ManuZ96/T3200_Manuel_Zieker/inhalt/strukturierung/eigenstaendigkeit.tex

% !TeX root = ../main.tex
% Zeile 1 legt fest das immer die main.tex kompiliert wird

\chapter*{Eigenständigkeitserklärung}

Hiermit erkläre ich, dass ich die vorliegende
Studienarbeit T3200 mit dem Titel „Entwicklung einer WordClock mit funktionalen Zusatzinformationen und Smart-Home-Integration“ selbstständig verfasst habe und keine anderen als die angegebenen Quellen und Hilfsmittel benutzt wurden.
Alle sinngemäß und wörtlich übernommenen Textstellen aus fremden Quellen wurden kenntlich gemacht.

\releaseLocation, \releaseDate
\vspace{2em}

\rule{6cm}{0.4pt}\\
Manuel Zieker
%Einkommentieren für 2. Author
% \rule{6cm}{0.4pt}\\
% <Authorname hier>\\
% \vspace{2em}
