ManuZ96/T3200_Manuel_Zieker/inhalt/abkürzungsverzeichnis/abkuerzungsverzeichniss.tex

% ========================
% VERWENDETE ABKÜRZUNGEN
% ========================
% (Erstes auftauchen)

%200
\newacronym{diy}{DIY}{Do-It-Yourself}
\newacronym{esp32}{ESP32}{Espressif 32 Mikrocontroller}
\newacronym{led}{LED}{Light Emitting Diode}
\newacronym{api}{API}{Application Programming Interface}
\newacronym{wlan}{WLAN}{Wireless Local Area Network}
%320
\newacronym{it}{IT}{Informationstechnik}
%330
\newacronym{ws2812b}{WS2812B}{Adressierbare RGB-LED mit integrierter Steuerelektronik}
\newacronym{rgb}{RGB}{Rot Grün Blau}
%340
\newacronym{iot}{IoT}{Internet of Things}
%351
\newacronym{esp32c6}{ESP32-C6}{Mikrocontroller von Espressif}
\newacronym{ble}{BLE}{Bluetooth Low Energy}
\newacronym{ieee802154}{IEEE 802.15.4}{Standard für drahtlose Netzwerke mit geringem Energieverbrauch}
\newacronym{usb}{USB}{Universal Serial Bus}
%352
\newacronym{ntp}{NTP}{Network Time Protocol}
%361
\newacronym{ip}{IP}{Internet Protocol}
\newacronym{dhcp}{DHCP}{Dynamic Host Configuration Protocol}
%362
\newacronym{http}{HTTP}{Hypertext Transfer Protocol}
\newacronym{tcp}{TCP}{Transmission Control Protocol}
\newacronym{html}{HTML}{Hypertext Markup Language}
\newacronym{css}{CSS}{Cascading Style Sheets}
\newacronym{url}{URL}{Uniform Resource Locator}
%372
\newacronym{https}{HTTPS}{Hypertext Transfer Protocol Secure}
\newacronym{ssl}{SSL}{Secure Sockets Layer}
\newacronym{tls}{TLS}{Transport Layer Security}
\newacronym{rest}{REST}{Representational State Transfer}
%510
\newacronym{dht22}{DHT22}{Digitaler Temperatur- und Feuchtigkeitssensor}
%520
\newacronym{json}{JSON}{JavaScript Object Notation}
%526
\newacronym{ui}{UI}{User Interface}
%600
\newacronym{3ddrucker}{3D-Drucker}{Gerät zur additiven Fertigung dreidimensionaler Objekte durch schichtweisen Materialauftrag}
%610
\newacronym{pla}{PLA}{Polylactid, ein biologisch abbaubarer thermoplastischer Kunststoff auf Basis nachwachsender Rohstoffe wie Maisstärke oder Zuckerrohr, der häufig im 3D-Druck eingesetzt wird}
\newacronym{3ddruck}{3D-Druck}{Fertigungsverfahren zur Herstellung dreidimensionaler Objekte}
\newacronym{cad}{CAD}{Computer-Aided Design}
\newacronym{usb-c}{USB-C}{Universal Serial Bus Typ C}
%620
\newacronym{gpio}{GPIO}{General Purpose Input/Output}
%620
\newacronym{wifi}{Wi-Fi}{Wireless Fidelity}

% ========================
% BEISPIELE LÖSCHEN!
% ========================
%\newacronym{DHBW}{DHBW}{Duale Hochschule Baden-Württemberg}

% ========================
% ANWENDUNG
% ========================
% Im Text abkürzung verwenden mit: \gls{<hier die abkürzung>}
% Bsp.: \gls{emf} --> erstes mal im Text kommt „elektromotorische Kraft (EMF)“
%                 --> beim 2. Mal und danach: "EMF"
