ManuZ96/T3200_Manuel_Zieker/inhalt/strukturierung/KI-Tools.tex

% !TeX root = ../main.tex
% Zeile 1 legt fest das immer die main.tex kompiliert wird

\chapter*{Anmerkung zum Einsatz von KI-Werkzeugen}

Künstliche Intelligenz entwickelt sich rasant weiter und wird in immer mehr Unternehmen produktiv genutzt, um Arbeitsabläufe zu beschleunigen und Ergebnisse effizienter zu erzielen. 
In dieser Arbeit wurde das Werkzeuge ChatGPT als Programmierhilfe und zur Überarbeitung der Grammatik verwendet. 
Die Verantwortung für Auswahl, Interpretation und Korrektheit der dargestellten Ergebnisse liegt bei mir.
