ManuZ96/T3200_Manuel_Zieker/inhalt/strukturierung/genus.tex

% !TeX root = ../main.tex
% Zeile 1 legt fest das immer die main.tex kompiliert wird

\chapter*{Anmerkung zum Genus des Substantivs}

Auf geschlechtsspezifische Umschreibung ist hier verzichtet worden. Ein Maskulinum - wie zum Beispiel der Student - meint (selbstredend) auch weibliche und diverse Personen.
