ManuZ96/T3200_Manuel_Zieker/inhalt/textkapitel/Kapitel 6/660_Integration der UI Steuerung.tex

\section{Integration der UI-Steuerung}
Zur Steuerung des Systems wird ein integrierter Webserver implementiert, welcher direkt auf dem Mikrocontroller ausgeführt wird.  
Die Kommunikation erfolgt über \gls{http}, sodass der Zugriff über einen Webbrowser möglich ist.
Die \gls{ui} ermöglicht das Ein- und Ausschalten der WordClock sowie die Anpassung von Helligkeit und Farbwerten.  
Die Verarbeitung der Nutzereingaben erfolgt über URL-Parameter.

\begin{lstlisting}[style=arduino,caption={Verarbeitung der Nutzereingaben über URL-Parameter.}]
void handleSet() {
  bool changed = false;

  if (server.hasArg("power")) {
    int p = server.arg("power").toInt();
    lampPower = (p != 0);
    changed = true;
  }

  if (server.hasArg("brightness")) {
    int b = server.arg("brightness").toInt();
    if (b < 0) b = 0;
    if (b > 100) b = 100;
    webBrightness = b;
    changed = true;
  }

  if (changed) {
    showHourWord(currentHour);
  }
  server.sendHeader("Location", "/", true);
  server.send(302, "text/plain", "OK");
}
\end{lstlisting}

Zusätzlich wird eine \gls{json}-Schnittstelle bereitgestellt, über die Statusinformationen für externe Anwendungen ausgelesen werden können.  
Die \gls{html}-Benutzeroberfläche wird dynamisch auf dem ESP32 erzeugt und über den integrierten \gls{http}-Server bereitgestellt.  
Weitere Funktionen zur Generierung der \gls{html}-Seite, zur Ausgabe der \gls{ui} und zur Verarbeitung von Browseranfragen befinden sich im vollständigen Programmcode in Anhang~\ref{apx:1}.
