ManuZ96/T3200_Manuel_Zieker/inhalt/textkapitel/Kapitel 3/363_JSON-Schnittstellen für Statusdaten.tex

\subsection{JSON-Schnittstellen für Statusdaten}
\gls{json} wird als Datenformat zur Übertragung von Zustandsinformationen eingesetzt.
Es handelt sich um ein standardisiertes, menschenlesbares Format, das unabhängig von der verwendeten Programmiersprache genutzt werden kann~\cite{wehner_json_iot}.
Dadurch eignet es sich für den Austausch von Daten zwischen unterschiedlichen Systemen und Komponenten.

Aufgrund seiner einfachen und kompakten Struktur verursacht \gls{json} nur geringen Kommunikationsaufwand.
Dies ist insbesondere in eingebetteten Systemen mit begrenzten Ressourcen von Vorteil, da unnötiger Overhead vermieden wird~\cite{wehner_json_iot}.
Durch die einfache Parsbarkeit und die geringe Komplexität eignet sich das \gls{json}-Format zudem für den Einsatz in heterogenen und verteilten Systemen~\cite{wehner_json_iot}.
Damit wird eine Grundlage geschaffen, um die WordClock in übergeordnete Systeme einzubinden oder Statusinformationen automatisiert auszuwerten.
