ManuZ96/T3200_Manuel_Zieker/inhalt/textkapitel/Volltext.tex

% !TeX root = ../main.tex
% Zeile 1 legt fest das immer die main.tex kompiliert wird

%   _________Kapitel 1_________
\input{inhalt/textkapitel/Kapitel 1/100_Einleitung.tex}
    \input{inhalt/textkapitel/Kapitel 1/110_Motivation und Problemstellung.tex}
    \input{inhalt/textkapitel/Kapitel 1/120_Zielsetzung der Arbeit.tex}
    \input{inhalt/textkapitel/Kapitel 1/130_Projektgegenstand und Abgrenzung.tex}

%   _________Kapitel 2_________
\input{inhalt/textkapitel/Kapitel 2/200_Marktanalyse und Relevanz des Projekts.tex}
    
%   _________Kapitel 3_________
\input{inhalt/textkapitel/Kapitel 3/300_Stand der Technik und Grundlagen.tex}
    \input{inhalt/textkapitel/Kapitel 3/310_Grundlegendes Funktionsprinzip von WordClocks.tex}
        \input{inhalt/textkapitel/Kapitel 3/311_Zeitdarstellung in natürlicher Sprache.tex}
    \input{inhalt/textkapitel/Kapitel 3/320_Der Begriff Smart Home.tex}
    \input{inhalt/textkapitel/Kapitel 3/330_Adressierbare RGB-LEDs als Anzeigeelement.tex}
    \input{inhalt/textkapitel/Kapitel 3/340_Entwicklung von Steuerungs- und Eingebetteten Systemen.tex}
    \input{inhalt/textkapitel/Kapitel 3/350_Mikrocontrollerbasierte Steuerung.tex}
        \input{inhalt/textkapitel/Kapitel 3/351_ESP32-C6-DEV-KIT-N8 als zentrale Steuereinheit.tex}
        \input{inhalt/textkapitel/Kapitel 3/352_Zeitsynchronisation über NTP.tex}
    \input{inhalt/textkapitel/Kapitel 3/360_Netzwerkbasierte Bedien- und Schnittstellenkonzepte.tex}
        \input{inhalt/textkapitel/Kapitel 3/361_WLAN-Anbindung eingebetteter Systeme.tex}
        \input{inhalt/textkapitel/Kapitel 3/362_HTTP-Webserver und lokale Browsersteuerung.tex}
        \input{inhalt/textkapitel/Kapitel 3/363_JSON-Schnittstellen für Statusdaten.tex}
    \input{inhalt/textkapitel/Kapitel 3/370_Datenquellen und externe Schnittstellen.tex}
        \input{inhalt/textkapitel/Kapitel 3/371_Sensordaten in IoT-Systemen.tex}
        \input{inhalt/textkapitel/Kapitel 3/372_Open-Meteo als externe Wetterdatenquelle.tex}
        \input{inhalt/textkapitel/Kapitel 3/373_Verarbeitung und Nutzung der Wetterdaten.tex}

%   _________Kapitel 4_________
\input{inhalt/textkapitel/Kapitel 4/400_Anforderungsanalyse.tex}
    \input{inhalt/textkapitel/Kapitel 4/410_Funktionale Anforderungen.tex}
    \input{inhalt/textkapitel/Kapitel 4/420_Technische Anforderungen.tex}
    \input{inhalt/textkapitel/Kapitel 4/430_Nicht-funktionale Anforderungen.tex}
        \input{inhalt/textkapitel/Kapitel 4/431_Optische Anforderungen.tex}

%   _________Kapitel 5_________
\input{inhalt/textkapitel/Kapitel 5/500_Architekturübersicht der WordClock.tex}
    \input{inhalt/textkapitel/Kapitel 5/510_Hardwarearchitektur.tex}
    \input{inhalt/textkapitel/Kapitel 5/520_Softwarearchitektur.tex}
        \input{inhalt/textkapitel/Kapitel 5/521_Initialisierung des Systems.tex}
        \input{inhalt/textkapitel/Kapitel 5/522_Zyklische Ablaufsteuerung.tex}
        \input{inhalt/textkapitel/Kapitel 5/523_Zeitverarbeitung und Synchronisation.tex}
        \input{inhalt/textkapitel/Kapitel 5/524_Zeit-Anzeige-Logik der WordClock.tex}
        \input{inhalt/textkapitel/Kapitel 5/525_Erweiterung durch Zusatzfunktionen.tex}
        \input{inhalt/textkapitel/Kapitel 5/526_Benutzerinteraktion über die Webschnittstelle.tex}
        \input{inhalt/textkapitel/Kapitel 5/527_Gesamtsystemübersicht der WordClock.tex}

%   _________Kapitel 6_________    
\input{inhalt/textkapitel/Kapitel 6/600_Realisierung des Systems.tex}
    \input{inhalt/textkapitel/Kapitel 6/610_Mechanische Konstruktion und Fertigung.tex}
    \input{inhalt/textkapitel/Kapitel 6/620_Installation der elektrischen Komponenten.tex}
    \input{inhalt/textkapitel/Kapitel 6/630_Aufbau der WordClock.tex}
    \input{inhalt/textkapitel/Kapitel 6/640_Implementierung der Software.tex}
    \input{inhalt/textkapitel/Kapitel 6/650_Anbindung externer Datenquellen.tex}
    \input{inhalt/textkapitel/Kapitel 6/660_Integration der UI Steuerung.tex}
    \input{inhalt/textkapitel/Kapitel 6/670_Aufbau der Benutzeroberfläche.tex}

%   _________Kapitel 7_________
\input{inhalt/textkapitel/Kapitel 7/700_Test und Evaluation.tex}
    \input{inhalt/textkapitel/Kapitel 7/710_Testkonzept und Vorgehensweise.tex}
    \input{inhalt/textkapitel/Kapitel 7/720_Modultests.tex}
    \input{inhalt/textkapitel/Kapitel 7/730_Integrationstests.tex}
    \input{inhalt/textkapitel/Kapitel 7/740_Systemtests und Dauerbetrieb.tex}
    \input{inhalt/textkapitel/Kapitel 7/750_Abnahme.tex}

%   _________Kapitel 8_________
\input{inhalt/textkapitel/Kapitel 8/800_Diskussion der Ergebnisse.tex}
    \input{inhalt/textkapitel/Kapitel 8/810_Erfüllung der Zielsetzung.tex}
    \input{inhalt/textkapitel/Kapitel 8/820_Technische und gestalterische Bewertung.tex}
    \input{inhalt/textkapitel/Kapitel 8/830_Herstellungskosten der WordClock.tex}
    \input{inhalt/textkapitel/Kapitel 8/840_Grenzen der Umsetzung.tex}

%   _________Kapitel 9_________
\input{inhalt/textkapitel/Kapitel 9/900_Fazit und Ausblick.tex}

%   _________Kapitel Beispiel_________
%\input{beispiele und befehle/Beispiele.tex}
