ManuZ96/T3200_Manuel_Zieker/inhalt/strukturierung/sperrvermerk.tex

% !TeX root = ../main.tex
% Zeile 1 legt fest das immer die main.tex kompiliert wird

\chapter*{Sperrvermerk}
%<Bei Bedarf eines Sperrvermerkes>
% Die vorgelegte
% %<Hier Bezeichnung+Title der Arbeit>
% basiert auf internen, vertraulichen Daten und Informationen
% des Unternehmens Roche Diagnostics Automation Solutions GmbH. In diese Arbeit dürfen
% Dritte, mit Ausnahme der Gutachter und befugten Mitglieder des Prüfungsausschusses, ohne
% ausdrückliche Zustimmung des Unternehmens und des Verfassers keine Einsicht nehmen. Eine
% Vervielfältigung und Veröffentlichung der 
% %<Hier Bezeichnung+Title der Arbeit>
% ohne ausdrückliche Genehmigung ist – auch auszugsweise – nicht erlaubt.
