ManuZ96/T3200_Manuel_Zieker/inhalt/textkapitel/Kapitel 1/120_Zielsetzung der Arbeit.tex

\section{Zielsetzung der Arbeit}
Ziele dieser Arbeit sind die Konzeptionierung, die Entwicklung und der Aufbau einer WordClock mit zusätzlichen informativen Funktionen. 
Die WordClock soll die Uhrzeit weiterhin in sprachlicher Form darstellen und es ist eine sekundengenaue Zeitanzeige vorgesehen. 
Darüber hinaus soll das System externe Daten verarbeiten und ausgewählte, informative Zusatzinformationen anzeigen. 

Die Architektur soll so ausgelegt werden, dass eine Einbindung in vernetzte Strukturen möglich ist. 
Es soll eine Smart-Home-Integration erfolgen, um so die externe Steuerung und Überwachung über ein mobiles Endgerät zu realisieren. 
Die Zielsetzung umfasst sowohl die Auslegung der elektronischen Hardware als auch die Entwicklung der notwendigen Software. 
Weiterhin wird die mechanische Konstruktion der Gehäuse- und Trägerelemente berücksichtigt. 
Es wird ein funktionsfähiger Prototyp, dessen Eigenschaften systematisch geprüft und bewertet werden, aufgebaut.
