ManuZ96/T3200_Manuel_Zieker/inhalt/textkapitel/Kapitel 1/130_Projektgegenstand und Abgrenzung.tex

\section{Projektgegenstand und Abgrenzung}
Gegenstand dieser Arbeit ist die Entwicklung eines prototypischen Gesamtsystems bestehend aus Elektronik, Software und mechanischer Konstruktion. 
Die Arbeit umfasst die Auswahl geeigneter elektronischer Komponenten, die Entwicklung einer Ansteuerung für die Anzeigeelemente und die Implementierung der Softwarelogik.
Weiterhin umfasst sie die Konstruktion und Fertigung mechanischer Bauteile mittels additiver Fertigungsverfahren. 
Ebenso wird die Integration externer Datenquellen umgesetzt. 

Nicht Bestandteil der Arbeit ist die Entwicklung eines serienreifen Produkts. 
Aspekte wie Zertifizierung, normgerechte Sicherheitsprüfung für den kommerziellen Vertrieb oder wirtschaftliche Serienoptimierung werden nicht behandelt. 
Ebenso erfolgt keine umfangreiche Marktanalyse, sondern nur eine grundlegende Analyse der bereitgestellten Funktionen und Defizite bei kommerziell vertriebenen Uhren in verschiedenen Preissegmenten.
Die Untersuchung konzentriert sich auf die technische Machbarkeit, die funktionale Umsetzung und die systematische Bewertung der entwickelten WordClock im Rahmen einer ingenieurwissenschaftlichen Studienarbeit.
