ManuZ96/T3200_Manuel_Zieker/inhalt/textkapitel/Kapitel 5/520_Softwarearchitektur.tex

\section{Softwarearchitektur}
Die Softwarearchitektur der WordClock ist als modulare Struktur aufgesetzt, in der einzelne Funktionsblöcke klar voneinander getrennt sind. 
Die Bestandteile sind die Initialisierung des Systems, die zyklische Ablaufsteuerung, die Zeitverarbeitung, die Anzeigelogik sowie die Zusatzfunktionen durch Sensorik und externe \gls{api}-Schnittstellen.
Die Kommunikation zwischen den Komponenten erfolgt über globale Zustandsvariablen, welche in festen Zeitintervallen aktualisiert und anschließend zur Anzeige verarbeitet werden.
