ManuZ96/T3200_Manuel_Zieker/inhalt/textkapitel/Kapitel 5/527_Gesamtsystemübersicht der WordClock.tex

\subsection{Gesamtsystemübersicht der WordClock}
Als Gesamtübersicht für die WordClock sind in Abb.~\ref{fig:hardwarearchitektur} die Hardware- und Netzwerkstruktur dargestellt.
Weiterhin sind alle Softwarefunktionen als Kurzübersicht mit Beschreibung in Anhang~\ref{apx:0} aufgelistet.

\begin{figure}[H]
    \centering
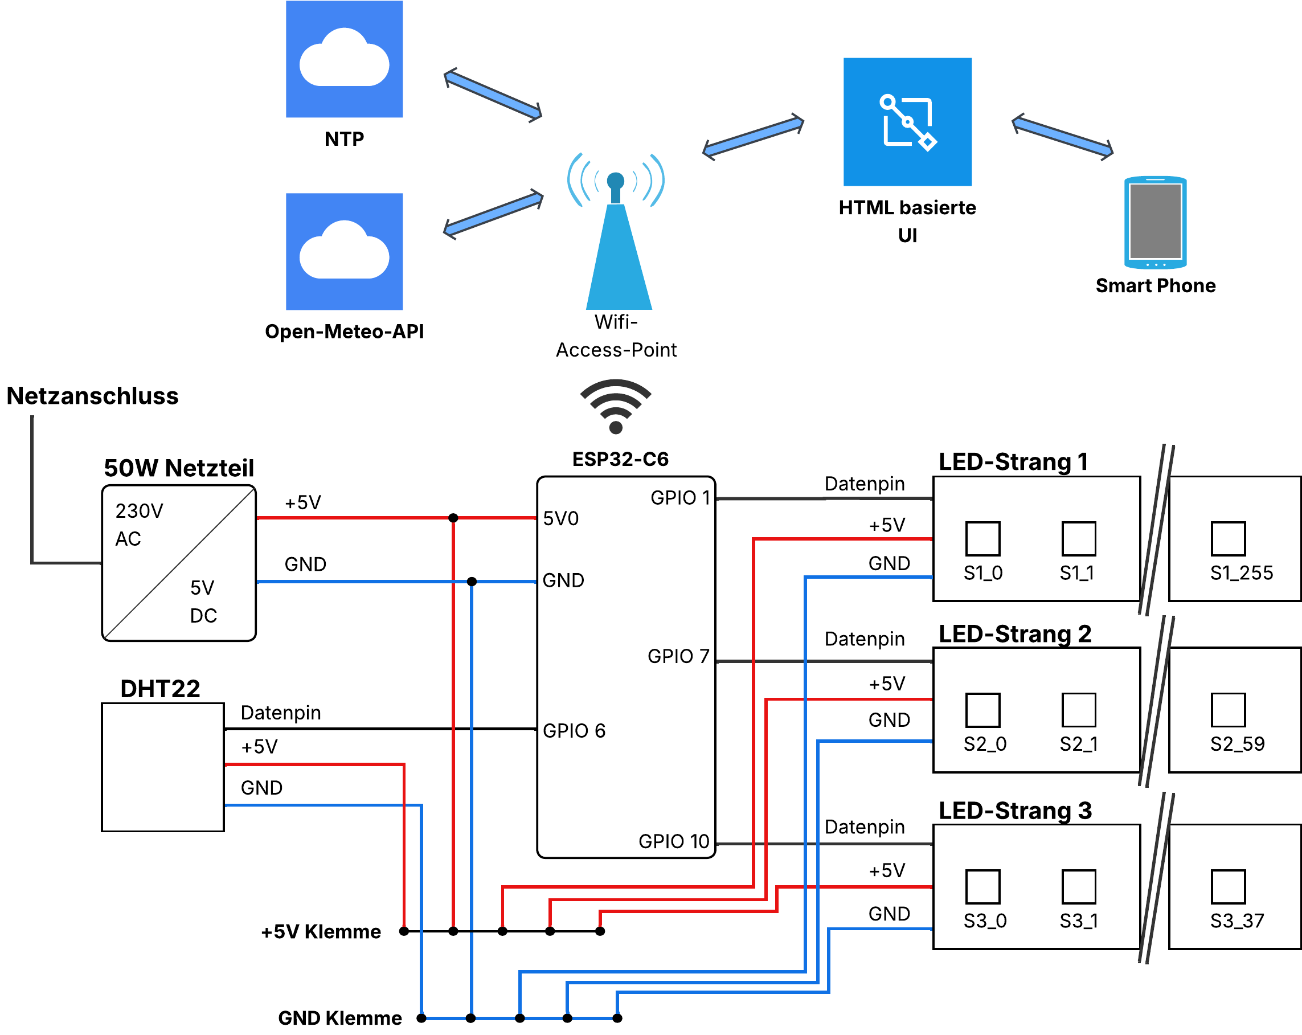
[picture p13: inhalt/bilder/BlockschaltbildWordClock.png]
    
    \caption[Gesamtübersicht für die WordClock]{Gesamtübersicht der Hardware- und Netzwerkstruktur für die WordClock.}
    \label{fig:hardwarearchitektur}
\end{figure}
