ManuZ96/T3200_Manuel_Zieker/inhalt/textkapitel/Kapitel 6/610_Mechanische Konstruktion und Fertigung.tex

\section{Mechanische Konstruktion und Fertigung}
Die mechanische Basis des Systems bildet eine Multiplexplatte, die als tragende Struktur dient.  
Auf dieser Grundplatte werden die \gls{led}-Streifen montiert und die Frontabdeckung verschraubt.  
Der Mikrocontroller wird auf der Rückseite der Platte befestigt.  
Für die Darstellung der Wortmatrix werden Bauteile mit der \gls{cad}-Software Inventor Professional 2026 von Autodesk konstruiert (vgl. Abb.~\ref{fig:Frontplatte}).  
Es existieren Mittelteile, Eckteile und Seitenteile (vgl. Abb.~\ref{fig:Frontplatte}).
Alle Bauteile desselben Typs folgen demselben konstruktiven Prinzip, unterscheiden sich jedoch in der jeweiligen Buchstabenbelegung oder Symbolik.  
In Abb.~\ref{fig:Frontplatte} ist die gesamte Frontplatte in der \gls{cad}-Software dargestellt.

\begin{figure}[H]
	\centering
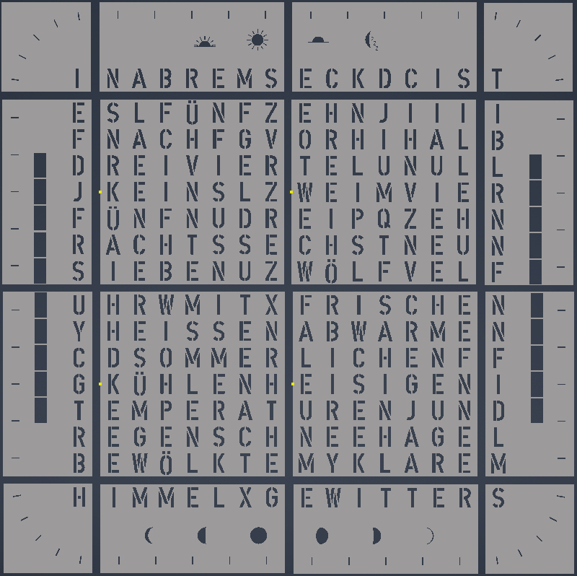
[picture p14: inhalt/bilder/CADUhrKomplett.png]
	
	\caption[Gesamte Frontplatte in der CAD-Software]{Gesamte Frontplatte in der CAD-Software, bestehend aus vier Eckteilen, acht Seitenteilen und vier Mittelteilen.}
	\label{fig:Frontplatte}
\end{figure}

Auf der Innenseite besitzt jeder Buchstabe eine eigene, abgeschlossene Box, damit keine anderen Buchstaben als die angesteuerten beleuchtet werden.
Diese Boxen sind in Abb.~\ref{fig:3DDruckbeispiel} zu sehen.
Die konstruierten Bauteile werden mit einem \gls{3ddruck} aus schwarzem \gls{pla} hergestellt.
Ein Beispiel dafür ist in Abb.~\ref{fig:3DDruckbeispiel} dargestellt.
\begin{figure}[H]
	\centering
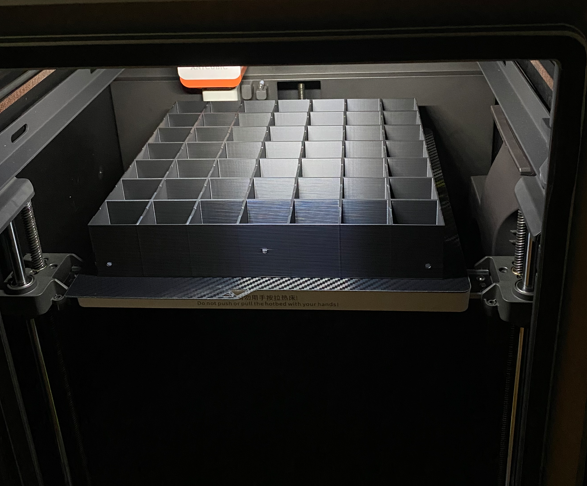
[picture p15: inhalt/bilder/Bauteil11_gedruckt.png]
	
	\caption[Fertiggestellter Druck des Frontplattenbauteils Nr. 11]{Fertiggestellter Druck des Frontplattenbauteils Nr. 11 auf dem 3D-Drucker Kobra S1 der Marke Anycubic~\cite{KobraS1}.}
	\label{fig:3DDruckbeispiel}
\end{figure}
Die gedruckten Bauteile bilden die Frontplatte sowie die Einhausung der \gls{led}s.  
Die Konstruktion basiert auf einer modularen Struktur aus insgesamt 16 Einzelteilen (vgl. Abb.~\ref{fig:Frontplatte}), welche miteinander verschraubt werden.  
Dadurch entsteht eine zusammenhängende Frontabdeckung mit den Abmessungen 692,00~mm $\times$ 692,00~mm $\times$ 51,00~mm.    

Die Hauptanzeige, die aus 16 $\times$ 16 Buchstaben besteht, dient der Darstellung der Uhrzeit, der Außentemperatur und des Wetters.  
Zusätzlich werden Symbole für die Zusatzfunktionen integriert, die links, rechts, ober- und unterhalb der Buchstabenmatrix angeordnet sind (vgl. Abb.~\ref{fig:Frontplatte}).  
Diese umfassen die Anzeige von Raumfeuchtigkeit, Innenraumtemperatur, Mondphase und Tageszeit (vgl. Abb.~\ref{fig:Frontplatte}).  
Die Sekundenanzeige ist am Außenrand der Frontplatte mit 60 Schlitzen realisiert (vgl. Abb.~\ref{fig:Frontplatte}).

Zur Verbesserung der Lichtverteilung werden für jeden Buchstaben sowie jedes Symbol separate Diffusorplättchen konstruiert (vgl. Abb.~\ref{fig:Diffusor}).  
Diese werden ebenfalls im 3D-Druckverfahren aus weißem \gls{pla} hergestellt und dann eingeklebt.  
Die Plättchen besitzen eine Dicke von 0,4~mm, was bei einer Layerhöhe von 0,2~mm pro Schicht, zwei Schichten entspricht. 
Das bedeutet, der Drucker druckt nur zwei Schichten \gls{pla} übereinander.  
Die optimale Dicke wurde empirisch ermittelt, um eine gleichmäßige Lichtstreuung ohne signifikante Helligkeitsverluste zu erreichen.  

\begin{figure}[H]
    \centering
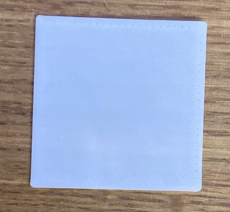
[picture p16: inhalt/bilder/Diffusorplaettchen.png]
    
    \caption[3D-gedrucktes Diffusorplättchen]{3D-gedrucktes Diffusorplättchen mit einer Dicke von 0,4~mm.}
    \label{fig:Diffusor}
\end{figure}  

Außerdem werden Halterungen für verschiedene Anwendungszwecke konstruiert und gedruckt.
Eine Halterung wird für den \gls{dht22} benötigt, um diesen an der Rückseite der WordClock anbringen zu können (vgl. Abb.~\ref{fig:DHT22Halter}).
Die Innenraumtemperatur und die Luftfeuchtigkeit sollen am Installationsort der WordClock gemessen werden.
Zusätzlich werden Bauteile als Abstandshalter zur Wand und gleichzeitig als Aufhängungspunkte konstruiert (vgl. Abb.~\ref{fig:Abstandshalter}).   
Weiterhin wird eine Halterung für den Mikrocontroller entwickelt, die an der Rückseite der Grundplatte montiert ist.  
Dadurch bleibt die \gls{usb-c}-Schnittstelle des Mikrocontrollers auch im montierten Zustand erreichbar (vgl. Abb.~\ref{fig:MontageplatteESP}).
Zuletzt wird noch eine Halterung für die Hohlsteckerbuchse, über die die WordClock mit +5~V Spannung versorgt wird, konstruiert.
Diese wird ebenfalls an der Rückseite montiert, sodass der Hohlstecker des 5~V-Netzteils ein- und ausgesteckt werden kann, ohne die WordClock von der Wand nehmen zu müssen (vgl. Abb.~\ref{fig:HohlsteckerHalter}).

\begin{figure}[H]
    \centering
    \begin{subfigure}[t]{0.45\textwidth}
        \centering
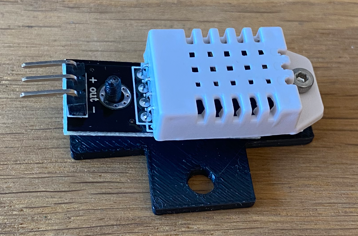
[picture p17: inhalt/bilder/DHT22AufHalter.png]
        
        \caption{Der auf der 3D-gedruckten Halterung montierte \gls{dht22}. Dieser wird an der Rückseite der Grundplatte montiert, um die Werte am Installationsort der WordClock zu messen.}
        \label{fig:DHT22Halter}
    \end{subfigure}
    \hfill
    \begin{subfigure}[t]{0.45\textwidth}
        \centering
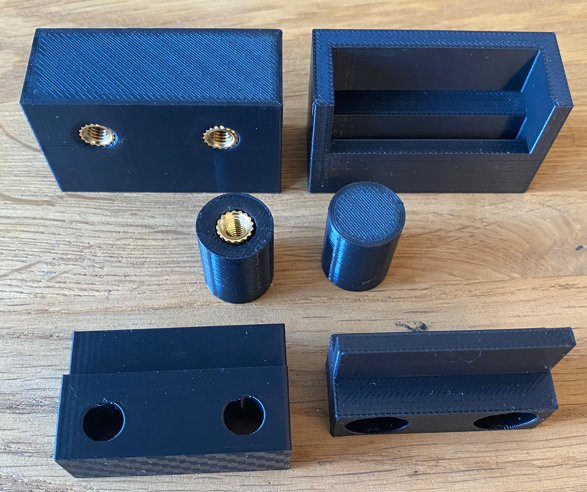
[picture p18: inhalt/bilder/Befestigunsmaterial.png]
        
        \caption{3D-gedruckte Aufhängungen (oben links und rechts) und Befestigungspunkte (unten links und rechts) der WordClock, welche an der Wand und an der WordClock befestigt werden, um diese an die Wand zu hängen. Zusätzlich 2 Abstandshalter (mittig links und rechts), die am unteren Ende der WordClock angebracht werden, damit diese im aufgehängten Zustand einen festen Auflagepunkt hat.}
        \label{fig:Abstandshalter}
    \end{subfigure}
    \vspace{0.8em}
    \begin{subfigure}[t]{0.45\textwidth}
        \centering
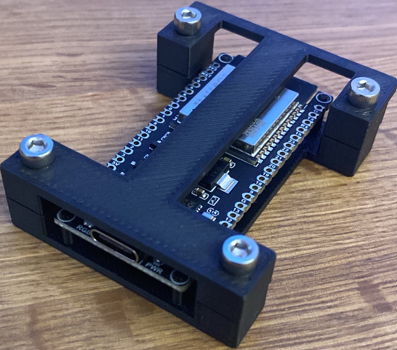
[picture p19: inhalt/bilder/ESPHalterEckView.png]
        
        \caption{3D-gedruckte Halterung für den \gls{esp32c6}, die an der Rückseite montiert wird.}
        \label{fig:MontageplatteESP}
    \end{subfigure}
    \hfill
    \begin{subfigure}[t]{0.45\textwidth}
        \centering
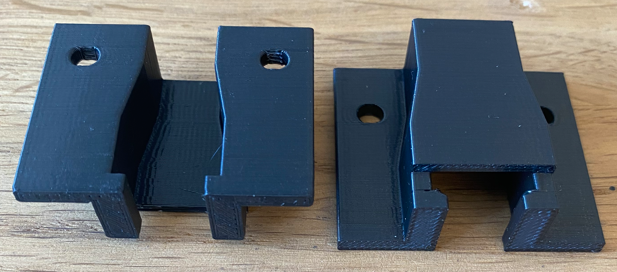
[picture p20: inhalt/bilder/VersorgungsanschlussHalter.png]
        
        \caption[Halterung für die Hohlsteckerbuchse an der WordClock]{Halterung für die Hohlsteckerbuchse an der WordClock (links von vorne, rechts von hinten) zur Spannungsversorgung mit +5~V.}
        \label{fig:HohlsteckerHalter}
    \end{subfigure}
    \caption{Zusätzliche Halterungen der WordClock.}
    \label{fig:Kleinteile}
\end{figure}
