ManuZ96/T3200_Manuel_Zieker/inhalt/textkapitel/Kapitel 8/810_Erfüllung der Zielsetzung.tex

\section{Erfüllung der Zielsetzung}
Ziel dieser Arbeit war die Konzeptionierung, Entwicklung und Umsetzung einer WordClock mit informativen Zusatzfunktionen.
Hierzu zählten die Integration externer Wetter- und Sensordaten sowie die Implementierung einer netzwerkbasierten Steuerung auf Basis einer modularen Hardware- und Softwarearchitektur.
Die entwickelte WordClock erfüllt die definierten Zielsetzungen vollumfänglich.
Durch die Erweiterung der sprachbasierten Zeitdarstellung um eine sekundengenaue Anzeige und zusätzliche Informationsdienste entstand ein multifunktionales Informationssystem.
Die Kombination aus Wetterdaten, Temperaturwerten und lokaler Sensorik ermöglicht eine Informationsdichte, die über den Funktionsumfang klassischer WordClocks hinausgeht.
Zudem erlaubt die implementierte Weboberfläche eine flexible Benutzerinteraktion sowie die präzise Anpassung verschiedener Anzeigeparameter.

Ein wesentlicher Aspekt der Zielsetzung war die Integration in eine Smart-Home-Umgebung.
Diese wurde durch netzwerkbasierte Schnittstellen realisiert, welche eine Kommunikation über das lokale Netzwerk ermöglichen.
Das System greift moderne Smart-Home-Konzepte auf und agiert als intelligentes, kommunikationsfähiges Teilsystem innerhalb des privaten Wohnumfelds.
Die plattformunabhängige Steuerung über mobile Endgeräte sowie die automatisierte Verarbeitung externer Daten ohne manuellen Benutzereingriff unterstreichen diesen Integrationsgrad.
Die gewählte modulare Struktur begünstigte zudem die unabhängige Entwicklung, Prüfung und Optimierung der einzelnen Systemkomponenten.
Somit liegt ein funktionsfähiger Prototyp vor, der die Anforderungen an Interkonnektivität und funktionale Erweiterungen erfüllt.
