ManuZ96/T3200_Manuel_Zieker/inhalt/textkapitel/Kapitel 8/820_Technische und gestalterische Bewertung.tex

\section{Technische und gestalterische Bewertung}
Die Systemintegration stellte aufgrund der Verknüpfung von Zeitdarstellung, Zusatzdaten und Netzwerkkommunikation hohe Anforderungen an die Entwicklung.
Die Hardwarearchitektur erwies sich als zweckmäßig, bei der insbesondere die Aufteilung der Anzeige auf mehrere \gls{led}-Stränge eine effiziente Strukturierung der Funktionsbereiche ermöglichte.
Parallel dazu bot die modulare Softwarearchitektur signifikante Vorteile bei der Implementierung und der systematischen Fehlersuche.
Während der Integrationstests wurde eine temporär hohe Leistungsaufnahme beim Einschaltvorgang identifiziert.
Dies machte eine Anpassung der ursprünglichen Netzteildimensionierung erforderlich und verdeutlichte die Notwendigkeit, Lastspitzen bei komplexen \gls{led}-Systemen frühzeitig in der Auslegungsphase zu berücksichtigen.

Im gestalterischen Bereich wurde eine homogene Lichtverteilung bei gleichzeitig klarer Trennung der Anzeigeelemente erreicht.
Die Integration zahlreicher Zusatzinformationen bedingt eine im Vergleich zu kommerziellen Produkten größere Bauform, um die Lesbarkeit der Anzeige zu gewährleisten.
Der implementierte Webserver bietet dabei einen erheblichen Mehrwert, da er eine benutzerfreundliche Konfiguration ermöglicht.
Insgesamt belegt die Umsetzung die technische Realisierbarkeit einer informationserweiterten WordClock trotz der Herausforderungen hinsichtlich der geometrischen Maße und der Anzeigefläche.
