ManuZ96/T3200_Manuel_Zieker/inhalt/textkapitel/Kapitel 8/840_Grenzen der Umsetzung.tex

\section{Grenzen der Umsetzung}
Trotz der erfolgreichen Realisierung unterliegt der Prototyp technischen und methodischen Grenzen.
Die notwendige Überdimensionierung des Netzteils aufgrund der Einschaltstromspitzen erhöhte die Herstellungskosten im Vergleich zum ursprünglichen Entwurf.
Hinsichtlich der Informationsdarstellung wurden Vereinfachungen vorgenommen; so wird die Mondphase lediglich in sechs diskreten Zuständen abgebildet.
Dies konnte zu geringfügigen Abweichungen gegenüber der astronomisch exakten Phase führen.
Zudem ist die volle Funktionalität des Systems an die Verfügbarkeit einer stabilen Netzwerkverbindung gekoppelt.

Methodisch beschränkt sich die Arbeit auf die Erstellung eines Einzelprototyps.
Aspekte einer industriellen Serienfertigung wurden nicht betrachtet, ebenso wenig wie eine Untersuchung der Langzeitstabilität im mehrmonatigen Dauerbetrieb.
Ebenso stehen Untersuchungen zum Alterungsverhalten der Komponenten und zur langfristigen Energieeffizienz noch aus.
Ungeachtet dieser Limitierungen stellt das System eine belastbare Grundlage für zukünftige Optimierungen und weiterführende technische Entwicklungen dar.
