ManuZ96/T3200_Manuel_Zieker/inhalt/textkapitel/Kapitel 9/900_Fazit und Ausblick.tex

\chapter{Fazit und Ausblick}
Im Rahmen dieser Studienarbeit wurde eine WordClock mit erweiterten Informations- und Zusatzfunktionen konzipiert, entwickelt und realisiert. 
Zielsetzung war die Integration einer klassischen sprachbasierten Zeitdarstellung mit modernen technischen Funktionen in einem Gesamtsystem. 
Die methodische Vorgehensweise umfasste die Anforderungsanalyse, die Entwicklung der Hardware- und Softwarearchitektur sowie die mechanische Konstruktion und abschließende Systemtests. 
Das finale System ermöglicht neben der Uhrzeit die Anzeige von Wetterdaten, Temperatur, Luftfeuchtigkeit sowie Mondphasen und verfügt über eine netzwerkbasierte Steuerungsschnittstelle. 
Der realisierte Prototyp bestätigt die Umsetzbarkeit einer funktionserweiterten Wortuhr unter Einhaltung der definierten technischen Anforderungen.

Die Projektumsetzung verdeutlicht die Komplexität interdisziplinärer Systeme an der Schnittstelle von Elektronik, Informatik und Mechanik. 
Es zeigte sich, dass die Implementierung zahlreicher Zusatzfunktionen den Ressourcenbedarf hinsichtlich Speicher, Spannungsversorgung und Integrationsaufwand signifikant steigert. 
Besonders hervorzuheben ist die erfolgreiche Smart Home-Integration, die über eine webbasierte Schnittstelle eine dezentrale Steuerung ermöglicht und das System als aktiven Teil des IoT positionierte. 
Wirtschaftlich konnte gezeigt werden, dass ein solches System zu Materialkosten von ca. 170~€ realisierbar ist, wodurch es sich als leistungsstarke und kosteneffiziente Alternative zu bestehenden Marktprodukten etabliert. 
Die erzielten Ergebnisse demonstrieren eine erfolgreiche Systemintegration und dienen als fundierte Basis für die Entwicklung vergleichbarer elektrotechnischer Anwendungen.

Zukünftige Weiterentwicklungen bieten Potenziale zur Optimierung der Energieeffizienz durch adaptive Helligkeitsregelungen oder spezialisierte Energiesparmodi. 
Im Bereich der Konnektivität sind Erweiterungen durch Smart Home-Standards oder eine Cloud-Anbindung zur globalen Steuerung denkbar. 
Die visuelle Darstellung lässt sich durch zusätzliche Animationen sowie individuell anpassbare Designs erweitern. 
Hinsichtlich der Hardware bietet die Optimierung der Wärmeabfuhr sowie die Untersuchung alternativer Fertigungsverfahren Ansätze zur Steigerung der Fertigungsqualität. 
Systematische Langzeituntersuchungen zum thermischen Verhalten und zur Dauerstabilität der Komponenten könnten die Zuverlässigkeit des Systems weiter validieren. 
Zusammenfassend stellt die vorliegende Arbeit eine belastbare Grundlage für fortführende technische Optimierungen und Funktionserweiterungen im Bereich der designorientierten Anzeigesysteme dar.
