ManuZ96/T3200_Manuel_Zieker/inhalt/textkapitel/Kapitel 3/350_Mikrocontrollerbasierte Steuerung.tex

\section{Mikrocontrollerbasierte Steuerung}
Die Steuerung der WordClock erfolgt durch einen Mikrocontroller, der als zentrale Verarbeitungseinheit sämtliche Funktionen koordiniert. 
Neben der Ansteuerung der Anzeige übernimmt dieser die Verarbeitung von Zeitinformationen, die Kommunikation mit externen Diensten sowie die Umsetzung der zugrunde liegenden Steuerlogik. 
Durch die Integration von Funkkommunikation und ausreichender Rechenleistung können moderne Mikrocontroller komplexe Aufgaben direkt im System ausführen.
