ManuZ96/T3200_Manuel_Zieker/inhalt/textkapitel/Kapitel 3/360_Netzwerkbasierte Bedien- und Schnittstellenkonzepte.tex

\section{Netzwerkbasierte Bedien- und Schnittstellenkonzepte}
Drahtlose Kommunikation stellt eine wesentliche Grundlage moderner eingebetteter Systeme dar. 
\gls{wlan}-basierte Mikrocontroller ermöglichen dabei die Übertragung von Daten über Funk und erlauben den Einsatz in unterschiedlichen Umgebungen ohne feste Verkabelung. 
Die Nutzung solcher Funktechnologien bildet die Basis für vernetzte Systeme, die flexibel und ortsunabhängig betrieben werden können~\cite{hernandez2022wifi}.
