ManuZ96/T3200_Manuel_Zieker/inhalt/textkapitel/Kapitel 3/370_Datenquellen und externe Schnittstellen.tex

\section{Datenquellen und externe Schnittstellen}
