ManuZ96/T3200_Manuel_Zieker/inhalt/textkapitel/Kapitel 5/500_Architekturübersicht der WordClock.tex

\chapter{Architekturübersicht der WordClock}
