ManuZ96/T3200_Manuel_Zieker/inhalt/textkapitel/Kapitel 2/260_Wetterdaten und externe Web-APIs.tex

\section{Wetterdaten und externe Web-APIs} \todo{text}
% Herkunft solcher Daten :Wetter-APIs, Ortsbezogene Wetterdaten, API-Verfügbarkeit

% Aktualisierungsintervalle

% Herausforderungen (Netzwerkabhängigkeit, Verfügbarkeit)

% Temperaturanzeige? z.B. Stufenweise <0Grad eiskalt <10grad kalt <20 grad frisch <28 warm >=29 heiß

% Wetterzustände (Sonne, Regen etc.)

% Mondphasen/Mondzyklus

% Symbolische Darstellung
