ManuZ96/T3200_Manuel_Zieker/inhalt/textkapitel/Kapitel 4/440_Anzeige- und Bedienkonzept.tex

\section{Mechanik- und Designkonzept} \todo{text}
Welche Informationen wie dargestellt werden
Interaktion über App
Farben, Modi
