ManuZ96/T3200_Manuel_Zieker/inhalt/textkapitel/Kapitel 3/300_Stand der Technik und Grundlagen.tex

\chapter{Stand der Technik und Grundlagen}
