ManuZ96/T3200_Manuel_Zieker/inhalt/textkapitel/Kapitel 4/460_Schnittstellen und Datenflüsse.tex

\section{Schnittstellen und Datenflüsse} \todo{text}
Kommunikation zwischen Modulen
Externe Schnittstellen
Datenverarbeitung
