ManuZ96/T3200_Manuel_Zieker/inhalt/bilder/ESPHalterTopView.png

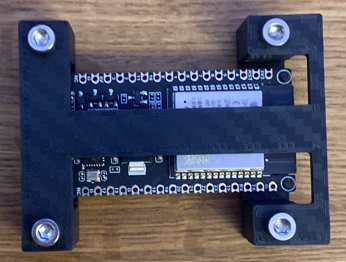
inhalt/bilder/ESPHalterTopView.png
