ManuZ96/T3200_Manuel_Zieker/inhalt/bilder/KomplettDruck.png

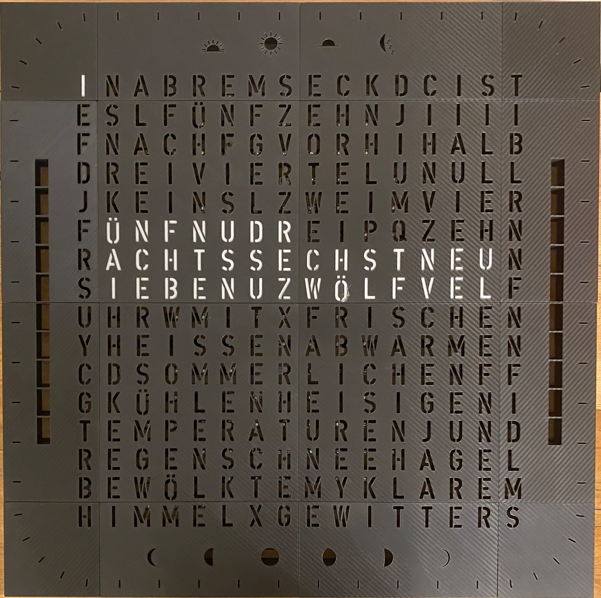
inhalt/bilder/KomplettDruck.png
