ManuZ96/T3200_Manuel_Zieker/(commit log)

2026-05-03 Aktueller Stand der Arbeit 20260503
2026-05-13 Aktueller und korrigierter Stand 13.05.26 18:30 Uhr
2026-05-17 Stand vor letzter korrektur und abgabe
2026-05-17 Hinzugefügt: Unterschriebene und abgegebene Version der Arbeit als pdf
